madisonwongtx/packmat/README.md

# packmat
Packages we added:
Load Cells/Calibration: HX711_ADC
Keypad: Keypad by Mark Stanley and Alexander Brevig Version 3.1.1
WIFI
String
SPI
Wire
Arduino JSON
