madisonwongtx/packmat/Week_0_Deliverables/finalProjectProposal.html

# PackageMat

## A 6.08 project by Madison Wong, Michael Iglesias, Claire Bao, and Ye Cheng Zheng

### Overview

Online orders have become an increasing part of modern commerce, so much focus is placed on ensuring that customers receive their deliveries. Delivery firms, especially, use barcodes and scanners to track packages en-route, allowing customers to know the real-time status of their packages. However, upon arrival at their destination, the responsibility of the package is placed on the customer. If the packages cannot be picked up immediately, they will be susceptible to theft. This lack of security on the receiving end is not only a problem for customers, but also sellers, who may have to replace or refund missing items.

To address this problem, we propose Package Mat (PackMat), a security system to monitor delivered packages. PackMat consists of two main components - a physical mat and a web interface. Once a package is delivered, the delivery driver will place the package on the mat and enter a key into the mat’s keypad. The key, which will be stored on the server and is visible on the web interface, must be entered again before removing the package. If the package is moved with a missing or incorrect key, an alarm would immediately sound and the web interface will update, notifying the user of the issue. As a result, while PackMat would not completely prevent theft, it discourages it by alarming the package thief as well as providing a monitoring system for users.

### Intended Functionality

There are several different components in our design that we hope to integrate for the intended functionality of a secure package security system. First, there is the physical package mat or area where the package would lay. Once pressure increases on the mat, the system enters confirmation. If there is not a new package, it returns to the restful state, otherwise it gives the user the opportunity to enter in a code to secure their package through the website. If the pressure changes at any point, an alarm will sound and will alert the user about the possibility of their package being stolen. The only way to turn off the alarm is to enter in the correct password on the package mat or through the website. If the code is entered correctly, the alarms turns off. The user can also enter in the passcode on the package mat when they pick up their package to avoid the alarm. This entire system is described concisely in the system block and state machine diagrams below.

### System Block Diagram

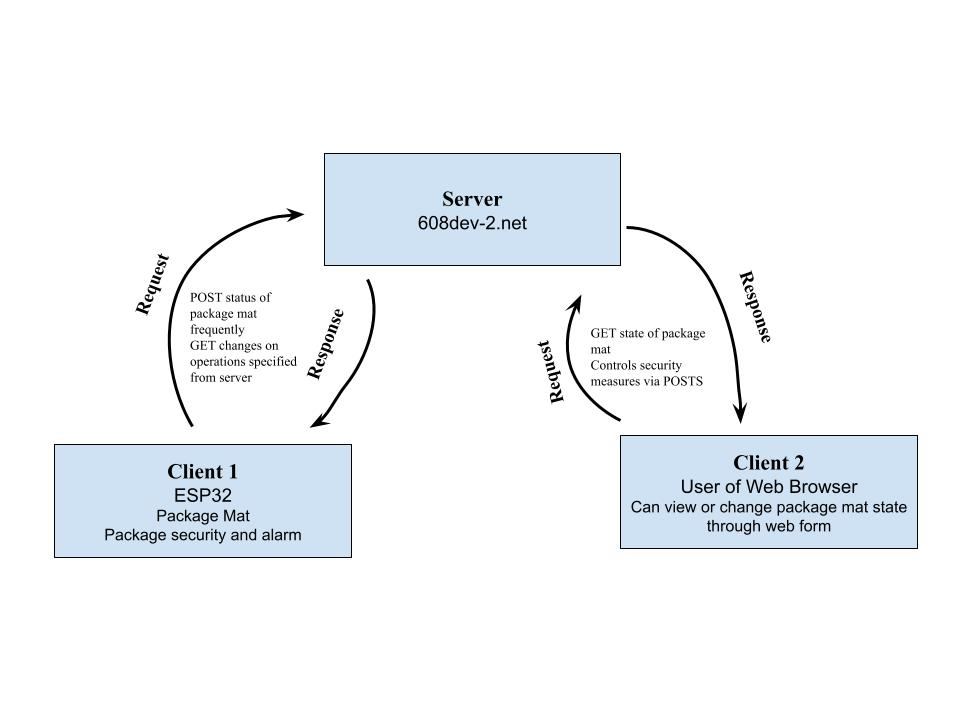
[picture p4: Week_0_Deliverables/System_Block_Diagram_6.08.jpg]


### State Machine

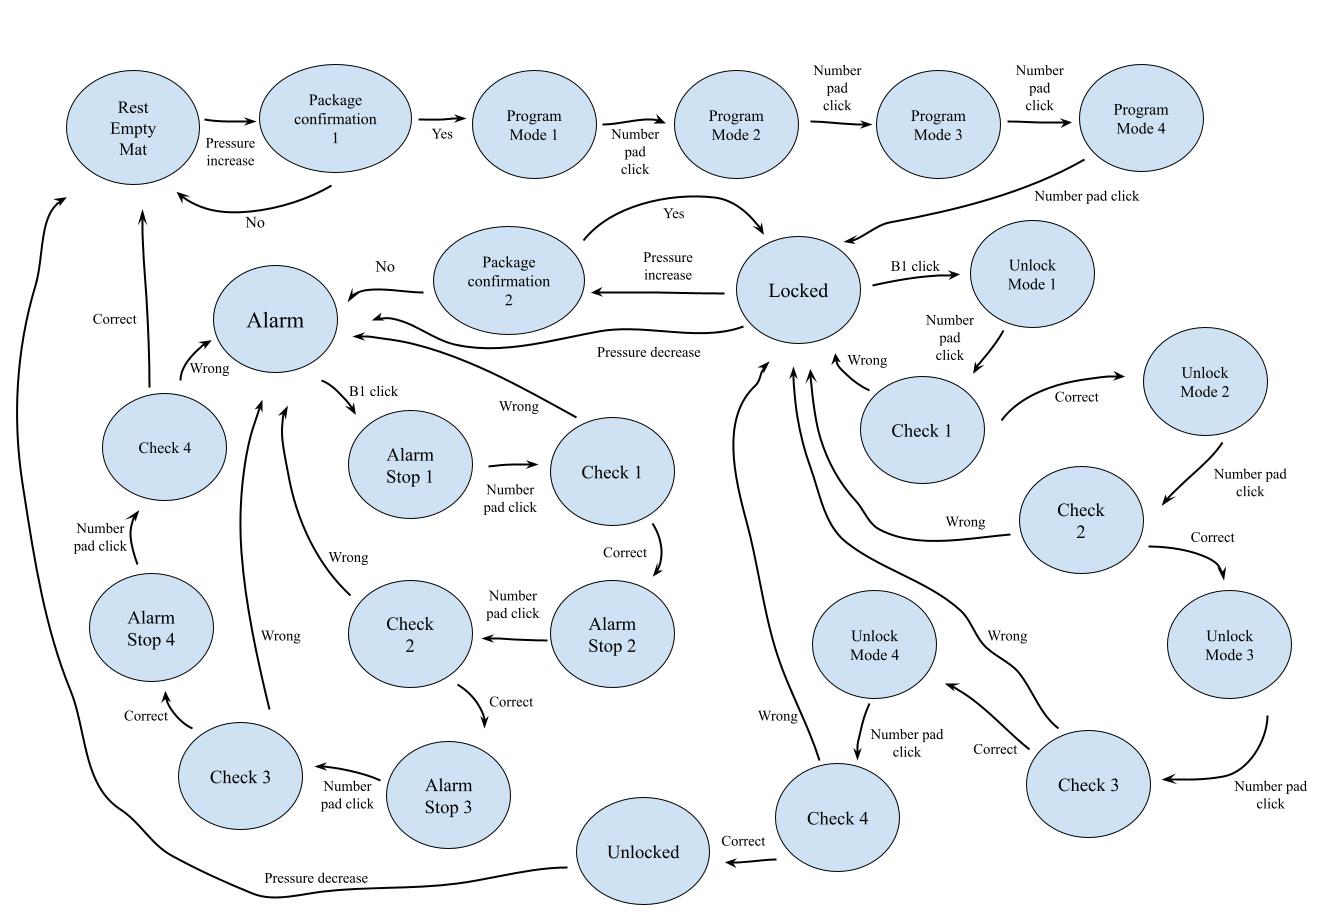
[picture p5: Week_0_Deliverables/State_Maching_6.08_Project.jpg]


### Technical Challenges

#### Website:

- May need to implement security/ login functionality, since a public site allows pass codes to be viewable by anybody
  - Might need cookies to maintain login status when refreshing page / moving to different page
  - Can compromise with individual proof-of-concept public page if not possible on the 6.08 dev server

#### Server:

- Might need to agree on some request formats / protocols ahead of time, otherwise changing and editing them will be difficult to manage later on as more code is added.

#### Physical Component:

- We need to design PackMat to be usable but not obstructive.
  - A physical mat might be ideal, but we may have issues fitting the components into a flat surface
  - We could also go for a larger dropbox
- Since the system is meant to be outside, how do we protect it from the weather or prevent it from going off due to the weight of precipitation?
  - We don't want to enclose the scale because that would limit the size of items placeable in the box
  - Maybe we can allow increases in height and a certain amount of decrease over time for evaporation? This will depend on how sensitive the load bar is.
  - Maybe we can design PackMat so that snow and rain runs off the device?

### Parts List

Item | Description | Item Number | Vendor | Price
Solderable Breadboard (https://www.adafruit.com/product/1606) | We will use this to integrate the physical components. | 1606 | Adafruit | $6.95
3x4 Number Pad: (https://www.adafruit.com/product/419) | This will be used to input pass codes into the device | 419 | Adafruit | $3.95
Load Cell Amplifier (https://www.sparkfun.com/products/13879?_ga=2.228677528.507380733.1648994760-989291874.1648994760) | Used to connect a load cell to the ESP32. Necessary for reading weight. | SEN-13879 ROHS | Sparkfun | $10.95
Load Bar (https://www.digikey.com/en/products/detail/sparkfun-electronics/SEN-13329/7393715) | Used to read weight; changes resistance based on pressure on bar; works up to 10kg (22 lbs) | SEN-13329 | digikey | $8.50

### Demos and Milestones

| Claire | | Ye Cheng | | Madison | | Michael
| Milestone | Demo | Milestone | Demo | Milestone | Demo | Milestone | Demo
Week 1 | Wire number pad and alarm and build 2 functions in Arduino: one that builds passcode and one that sounds an alarm | Show that when sequence is entered into number pad and matches hard-coded numbers, alarm will sound for 5 seconds | Server: Persistent storage and requests for getting / posting pass codes and alarm status Website: Barebones site that updates passcode and alarm status according to PackMat status | Show passcode updating on the site when updated on ESP32 (by manually changing hard-coded passcode) Show that website updates when alarm sounds | Initial coding and outline of the full state machine in Arudino as described in the State Machine header. | Can test by running code and inputting print statements to check if states are changing in correct order based off simple button press. | Wire up pressure sensor and connect it to Load Cell Amplifier and calibrate it using a known weight. | Show that load bar is sensitive to tiny objects through output from Serial Monitor.
Week 2 | Connect the two functions so that the number pad and alarm interact the way it should | When the passcode is entered correctly the alarm goes off, but if it is entered incorrectly, LCD will show a message saying incorrect. Passcode will still be hard-coded | Website: Site now tells the user if a package is or isn't on the mat, instead of just showing passcode. Implement an updating list of all times alarm has gone off. Implement UI to enter passcode and stop alarm. | Show that the site displays the presence of a package on mat (after the passcode is entered). Show updating list of alarms by setting off alarms multiple times Show that alarm stops when passcode is entered on website | Implement pressure sensor functionality (after it has been wired) and integrate with all states that are affected by it. Examples include decrease in pressure during locked state changes state to alarm state. | Change in pressure prompts Alarm screen on LCD (and can show my print statement). | Make a platform for the package to rest on | Show that when package is removed LCD Alarm screen turns
Week 3 | Implement passcode-setting functionality | Press button to set code and, for debugging purposes, print set code onto LCD screen. Then show that alarm turns off when it is correct and doesn't turn off when it isn't correct. | Server: Persistent storage for accounts and GET/POST requests for logging in Website: Implement login functionality and individual profiles. | Show different users logging into website, and that their respective pages update differently depending on which PackMat device is being used. | Implement alarm and code entry functionality (after both have been wired) and integrate with states that are affected by it. Examples include initial code setting with increase in pressure and turning off alarm. | Entering the correct code enters unlocked mode on screen or secure mode. Or incorrect code entries continue to stay in the alarm state. (can show entrance into states by print statements in arduino). | Notify user/website when package is removed from mat | When package is removed from mat website is notified through POST request which makes alarm goes off
Week 4 | Clean up code and write http post request to webpage when alarm gets triggered | Show a presentable way of FSM for alarm and numberpad working and a serial print ln of the get request being sent and the appropriate response being received | CSS and final touches to the website; clean up server API | Display a (hopefully) nice-looking web page to interface with the PackMat hardware, which updates according to events from the ESP32 and is able to control the PackMat's security functionality | Integrate functionalities with website so that the user can control the package map from different location. | Show that entering code from website can turn off the alarm on package mat. | Solder all components in a PCB and hide them in the platform for the PackMat | Show a somewhat aesthetic physical product of PackMat

### On Campus Resources

May use lab time to work on project together but not many other on campus resources will be needed.

We'll likely need access to a wood shop and laser cutter to make the device. These are all available at the MIT MakerWorkshop (https://makerworkshop.mit.edu), which we can get access to by signing up for orientation & training.

### Splitting the Work

Madison: In charge of state machine, designing the flow of system, and integration.

Michael: In charge of hardware components with wiring and accessing their data/functions.

Ye Cheng: In charge of the server side and web development portion of the system.

Claire: In charge of coding functions of system, specifically for alarm and numberpad, as well as integration.
