madisonwongtx/packmat/(commit log)

2022-04-06 wrong madi
    Lol I don't think I'm the Madi Wong you wanted to add to this project. But you *did* add an MIT student (albeit a '21 and current MEng) so that's a lucky coincidence. Anyway, good luck with your 6.08 final project! Also if you ever get Daniel Klahn or Diana Voronin for a checkoff, tell them Madi says hi.
2022-04-15 combined calibration
2022-04-15 calibration set up in 608sm
2022-04-15 calibraton change
2022-04-18 updated state machine without calibration
2022-04-20 Change integrated code to the new calibration scheme
2022-04-28 initial lcd prints completed
2022-05-01 LCD print screens finalized
2022-05-04 fixed user/pass input and reformated code
    [Calibration.ino, input_helpers.ino, lcd_helpers.ino, packmat_fsm.ino, request_helpers.ino, src.ino]
2022-05-08 Remove solderable breadboard from parts list
2022-05-10 Michael circuit schematic and youtube vids
